xXala011/blackSonic/Soporte Mbappe v2.stl

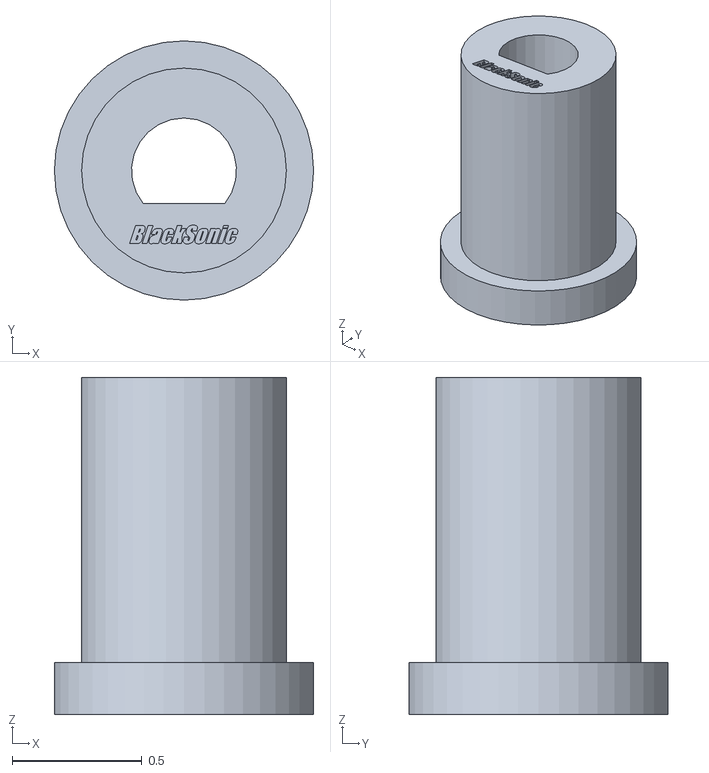
[picture p8: CAD file, 2024-02-07]
Soporte Mbappe v2.stl
1.00 x 1.00 x 1.30
