xXala011/blackSonic/Soporte Mbappe 3D v1.stl

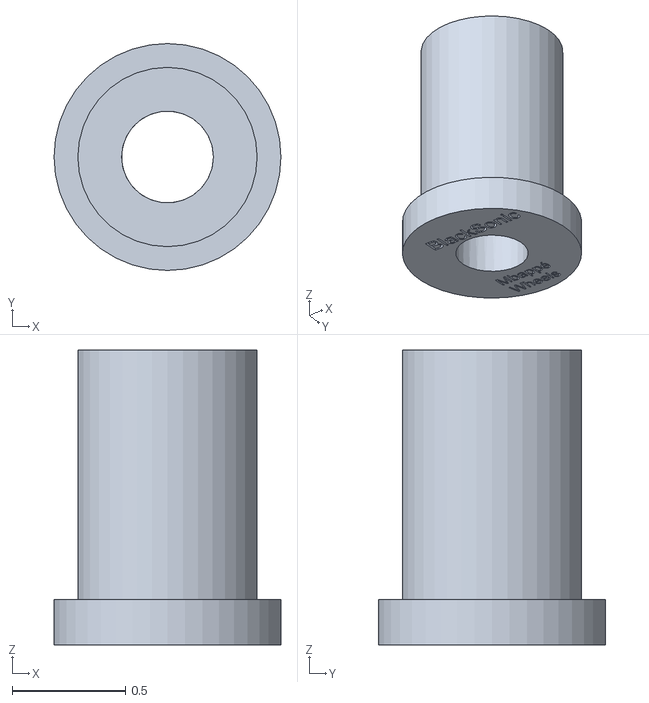
[picture p9: CAD file, 2024-02-04]
Soporte Mbappe 3D v1.stl
1.00 x 1.00 x 1.30
