xXala011/blackSonic/(commit log)

2023-08-23 Abriendo el repositorio
    [Flash Forma.kicad_pcb, Flash Forma.kicad_sch, puente H.kicad_pcb, puente H.kicad_sch]
2023-08-23 Infrarrojos PCB v0.1
    [QRE113.kicad_pcb, QRE113.kicad_sch]
2023-08-23 COrrijiendo ramas
    [Flash Forma.kicad_pcb, Flash Forma.kicad_sch, puente H.kicad_pcb, puente H.kicad_sch]
2023-08-23 Yes
    afafsff
    [Flash Forma.kicad_pcb, Flash Forma.kicad_sch, QRE113.kicad_pcb, QRE113.kicad_sch, puente H.kicad_pcb, puente H.kicad_sch]
2023-08-25 Borrando y reacomodando archivos
    [Flash Forma.kicad_pcb, Flash Forma.kicad_sch, puente H.kicad_pcb, puente H.kicad_sch]
2023-08-25 Arreglando Error
    [Flash Forma.kicad_pcb, Flash Forma.kicad_sch, QRE113.kicad_pcb, QRE113.kicad_sch, puente H.kicad_pcb, puente H.kicad_sch]
2023-08-25 Arreglando errores de diseño
    [Plaqueta Mani.kicad_pcb, Plaqueta Mani.kicad_sch, QRE113.kicad_pcb, puente H.kicad_pcb, puente H.kicad_sch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]
2023-08-25 Arreglando Puente H
    [puente H.kicad_pcb, puente H.kicad_sch]
2023-08-30 Agregue la plaqueta main del velocista v0.1
    [Plaqueta mani.kicad_pcb, Plaqueta mani.kicad_sch]
2023-09-01 PLaqueta Mani Milton
    [Plaqueta Mani.kicad_pcb, Plaqueta Mani.kicad_sch]
2023-09-26 Agregue leds y actualice los pads del plaqueta mani
    [Plaqueta mani.kicad_pcb, Plaqueta mani.kicad_sch]
2023-10-20 Agregue el codigo de blacksonic 1.0
    Falta testear, por lo tanto los valores son experimentales..
2024-02-04 Soporte Rueda v1.1
    [QRE113.kicad_sch, Soporte Mbappe 3D v1.stl]
2024-02-04 Soporte Mbappe v1.01
    [Plaqueta Mani.kicad_pcb, Plaqueta Mani.kicad_sch, Plaqueta mani.kicad_pcb, Plaqueta mani.kicad_sch, QRE113.kicad_pcb, puente H.kicad_pcb, puente H.kicad_sch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]
2024-02-07 Soporte Mbappe v2
    [Soporte Mbappe v2.stl]
